uwsunlab/Kamome/Kamome_Pics/Kamome_Electronics.JPG

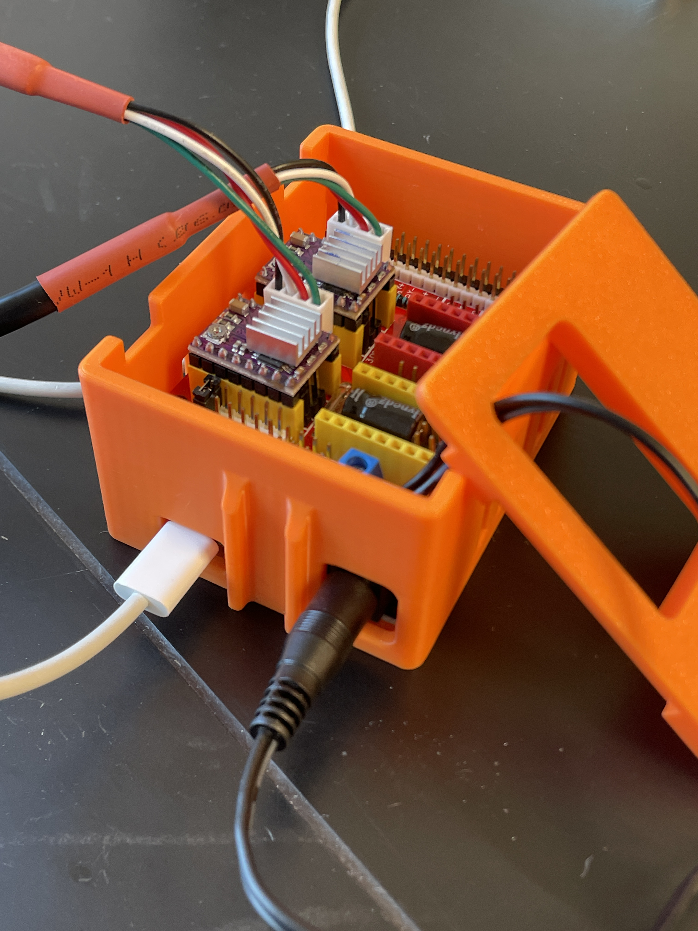
Kamome_Pics/Kamome_Electronics.JPG
