uwsunlab/Kamome/Kamome_Pics/Kamome_OT2_Setup.png

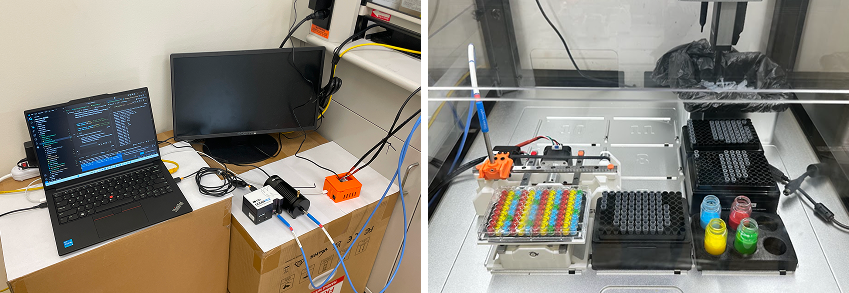
Kamome_Pics/Kamome_OT2_Setup.png
