uwsunlab/Kamome/README.md

# Welcome to Kamome's user and build guide!

## How to Use

## How to Build
