uwsunlab/Kamome/Kamome_Pics/Kamome_OT2_Pipetting.JPG

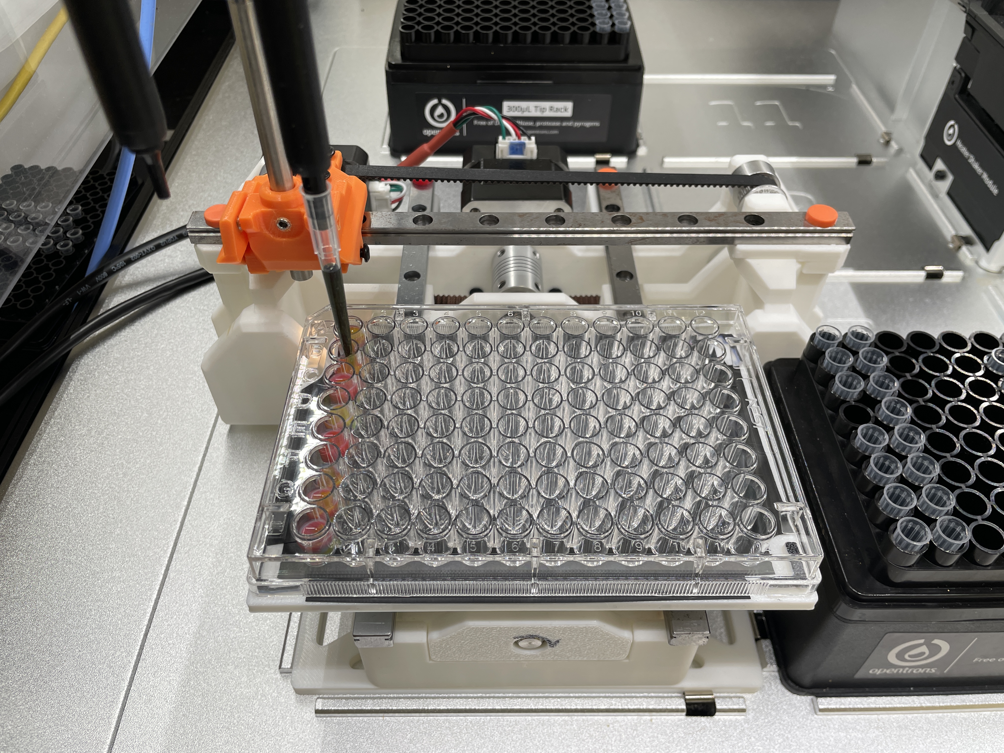
Kamome_Pics/Kamome_OT2_Pipetting.JPG
