uwsunlab/Kamome/Kamome_Pics/Kamome_OT2_Scanning.png

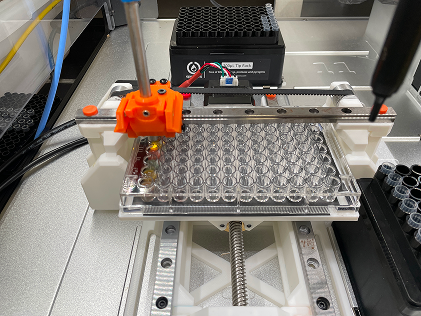
Kamome_Pics/Kamome_OT2_Scanning.png
