uwsunlab/Kamome/Kamome_Pics/Kamome_OT2_stationary.png

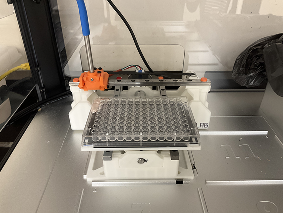
Kamome_Pics/Kamome_OT2_stationary.png
