uwsunlab/Kamome/Kamome_Pics/render_back.png

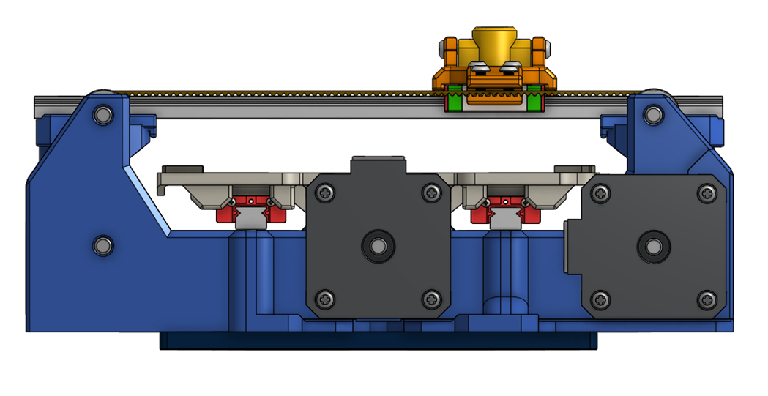
Kamome_Pics/render_back.png
