uwsunlab/Kamome/Kamome_Pics/render_front.png

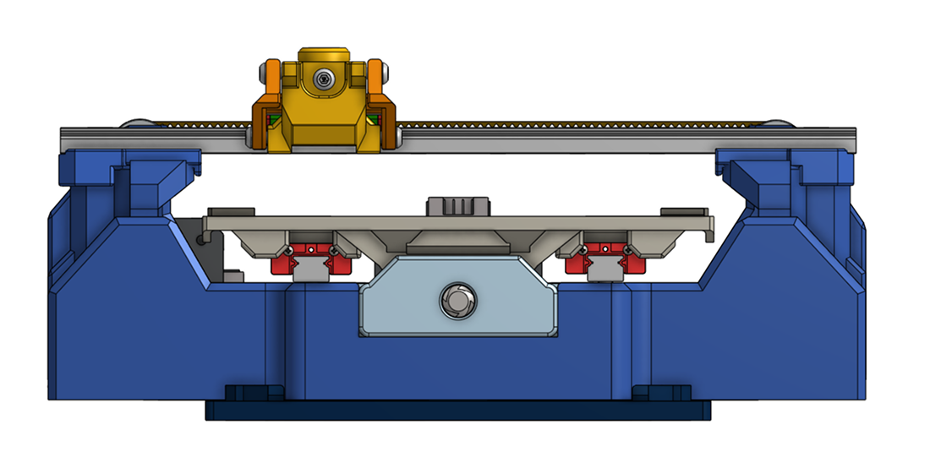
Kamome_Pics/render_front.png
