uwsunlab/Kamome/Kamome_Pics/render_frontright.png

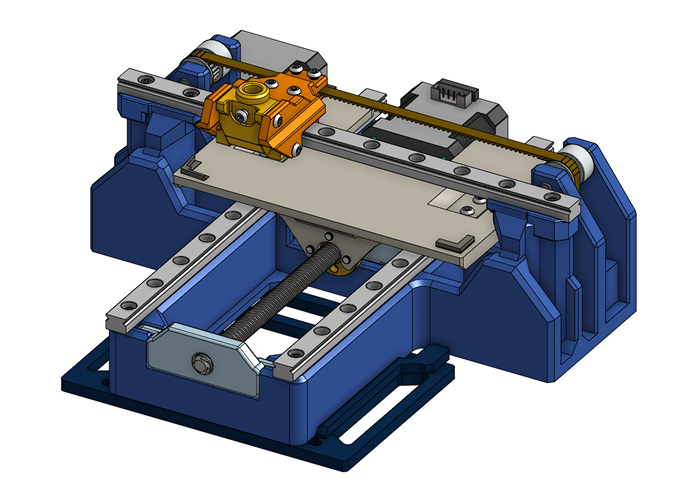
Kamome_Pics/render_frontright.png
