uwsunlab/Kamome/Kamome_Pics/render_frontright_all.png

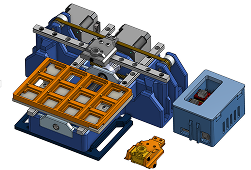
Kamome_Pics/render_frontright_all.png
