uwsunlab/Kamome/Kamome_Pics/render_top.png

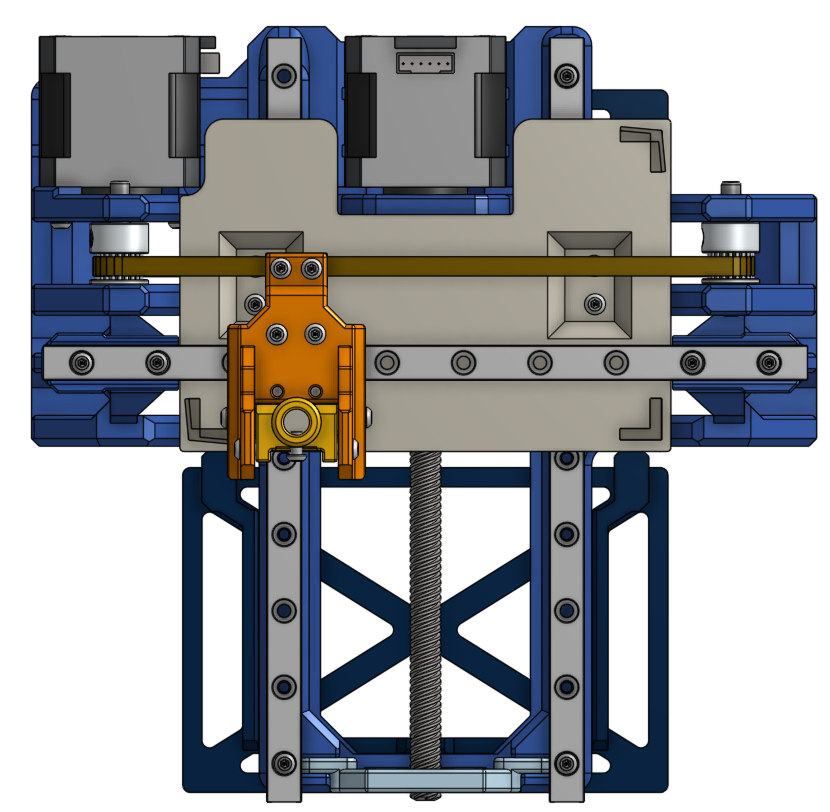
Kamome_Pics/render_top.png
