uwsunlab/Kamome/3D Print STEP files/Main Structure/Main Structure.step

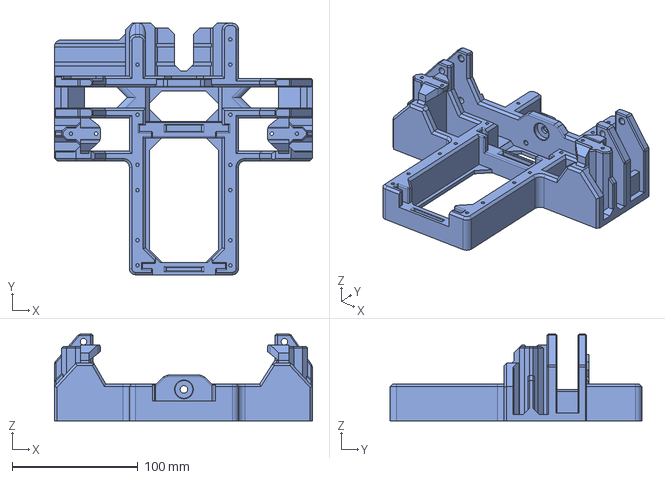
[picture p11: CAD file, 2025-05-07]
3D Print STEP files/Main Structure/Main Structure.step
205.5 x 200.4 x 69.0 mm
