uwsunlab/Kamome/3D Print STEP files/Custom Lab Plate Options/Thinfilm Plate.step

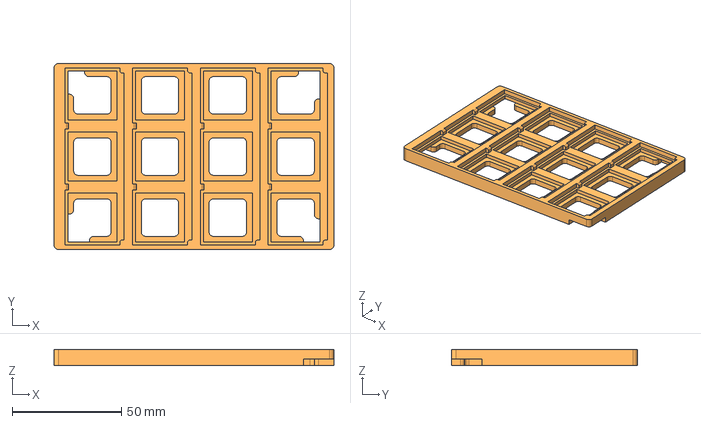
[picture p12: CAD file, 2025-05-07]
3D Print STEP files/Custom Lab Plate Options/Thinfilm Plate.step
128.0 x 85.0 x 7.50 mm
