uwsunlab/Kamome/3D Print STEP files/Electronics Box/Arduino Electronics Box.step

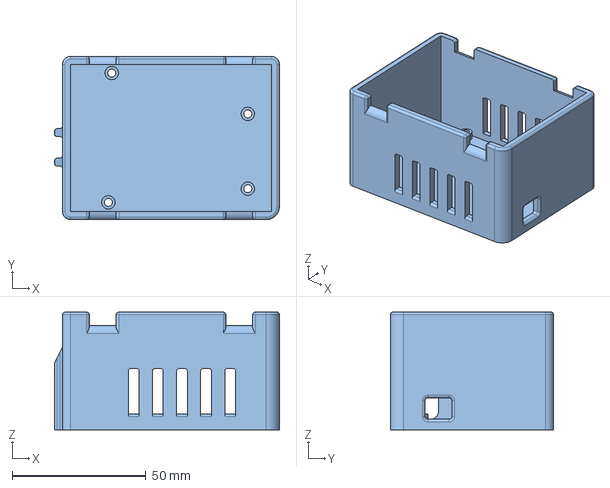
[picture p13: CAD file, 2025-05-07]
3D Print STEP files/Electronics Box/Arduino Electronics Box.step
84.0 x 61.0 x 44.0 mm
