uwsunlab/Kamome/3D Print STEP files/Probe Carriage Options/Vertical Probe Holder.step

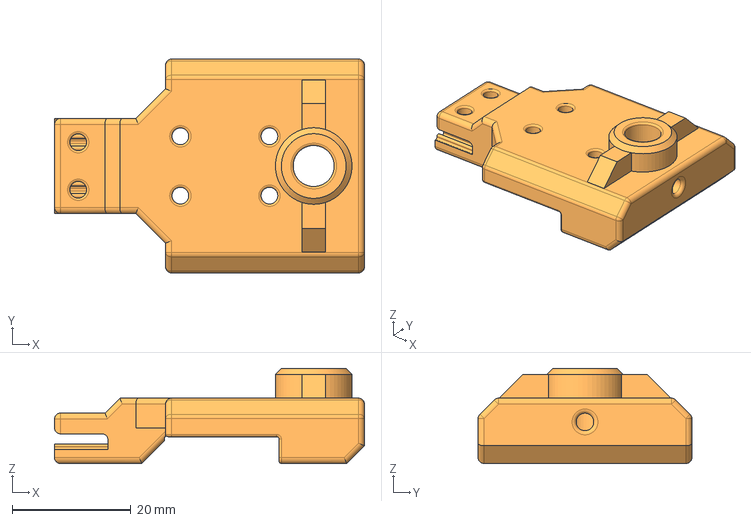
[picture p14: CAD file, 2025-05-07]
3D Print STEP files/Probe Carriage Options/Vertical Probe Holder.step
52.2 x 36.0 x 16.0 mm
