uwsunlab/Kamome/3D Print STEP files/Electronics Box/Arduino Electronics Box Roof.step

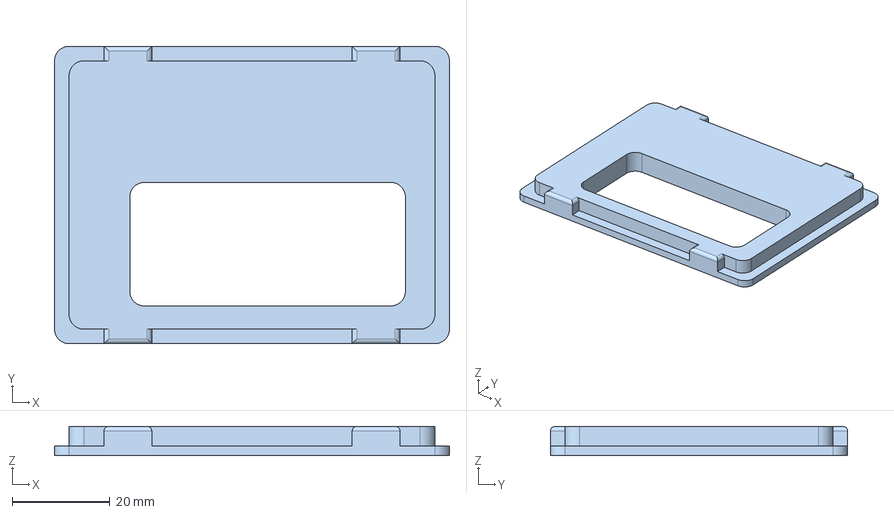
[picture p15: CAD file, 2025-05-07]
3D Print STEP files/Electronics Box/Arduino Electronics Box Roof.step
81.0 x 61.0 x 6.00 mm
