uwsunlab/Kamome/3D Print STEP files/Main Structure/Base Attachment Front Clip.step

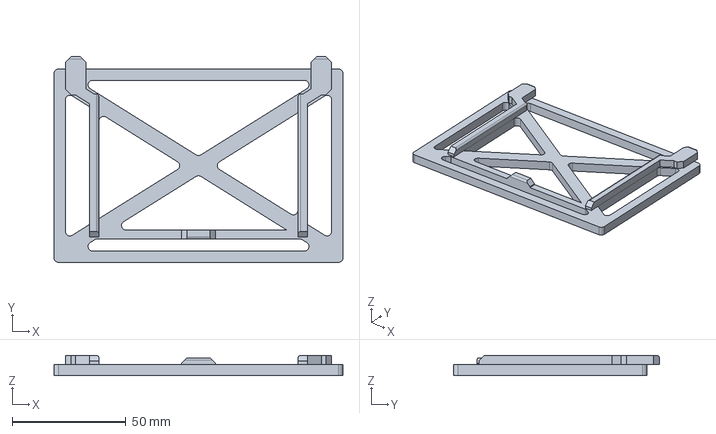
[picture p16: CAD file, 2025-05-07]
3D Print STEP files/Main Structure/Base Attachment Front Clip.step
127.0 x 90.4 x 8.80 mm
