uwsunlab/Kamome/3D Print STEP files/Probe Carriage Options/Angled Probe Holder Part 2.step

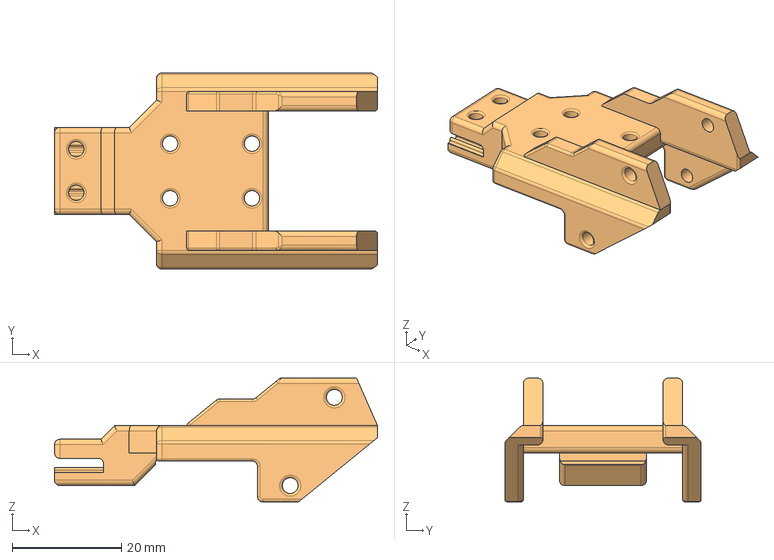
[picture p17: CAD file, 2025-05-07]
3D Print STEP files/Probe Carriage Options/Angled Probe Holder Part 2.step
59.2 x 36.0 x 22.7 mm
