uwsunlab/Kamome/3D Print STEP files/Main Structure/Base Attachment Universal.step

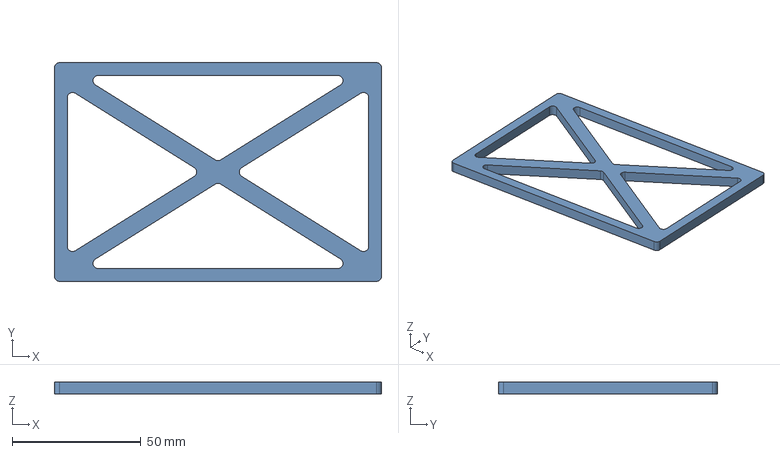
[picture p18: CAD file, 2025-05-07]
3D Print STEP files/Main Structure/Base Attachment Universal.step
127.0 x 85.0 x 4.80 mm
