uwsunlab/Kamome/3D Print STEP files/Probe Carriage Options/Angled Probe Holder Part 1.step

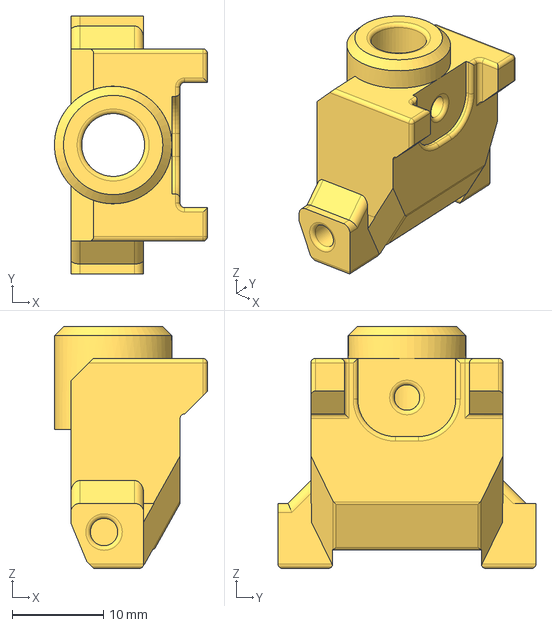
[picture p19: CAD file, 2025-05-07]
3D Print STEP files/Probe Carriage Options/Angled Probe Holder Part 1.step
16.8 x 28.3 x 26.6 mm
