uwsunlab/Kamome/3D Print STEP files/Main Structure/Plate Carriage.step

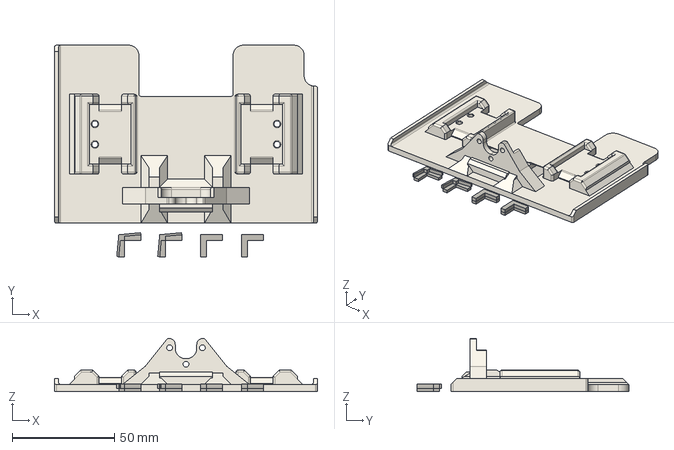
[picture p20: CAD file, 2025-05-07]
3D Print STEP files/Main Structure/Plate Carriage.step
128.5 x 103.4 x 26.0 mm
