uwsunlab/Kamome/3D Print STEP files/Main Structure/Guide Rail Support Right.step

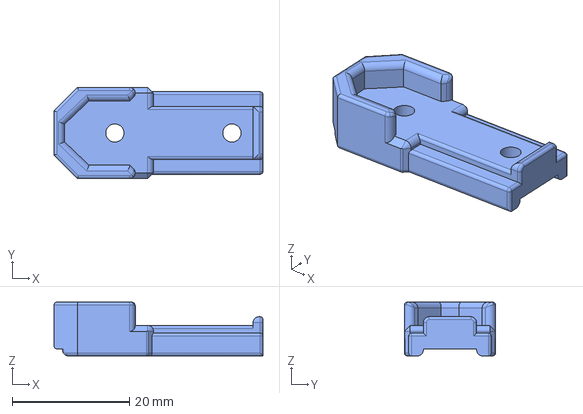
[picture p21: CAD file, 2025-05-07]
3D Print STEP files/Main Structure/Guide Rail Support Right.step
35.7 x 15.6 x 9.20 mm
