uwsunlab/Kamome/3D Print STEP files/Main Structure/Guide Rail Support Left.step

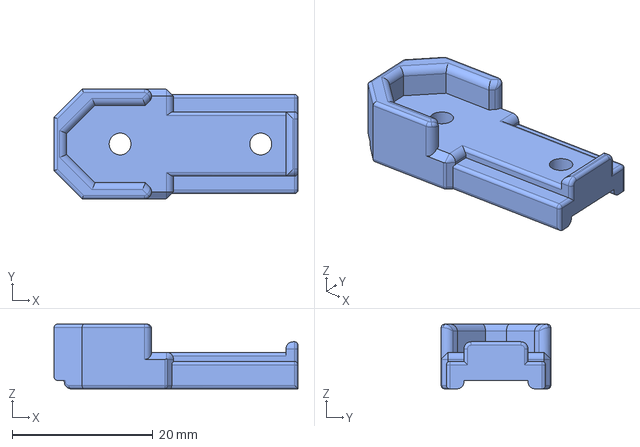
[picture p22: CAD file, 2025-05-07]
3D Print STEP files/Main Structure/Guide Rail Support Left.step
34.7 x 15.6 x 9.20 mm
