uwsunlab/Kamome/3D Print STEP files/Main Structure/Base Attachment Back Clip.step

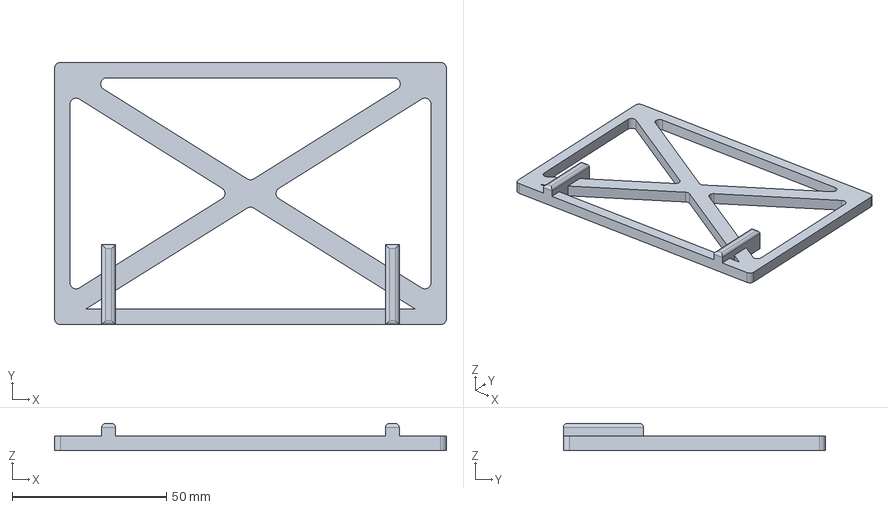
[picture p23: CAD file, 2025-05-07]
3D Print STEP files/Main Structure/Base Attachment Back Clip.step
127.0 x 85.0 x 8.80 mm
