uwsunlab/Kamome/3D Print STEP files/Main Structure/Lead Screw Modules.step

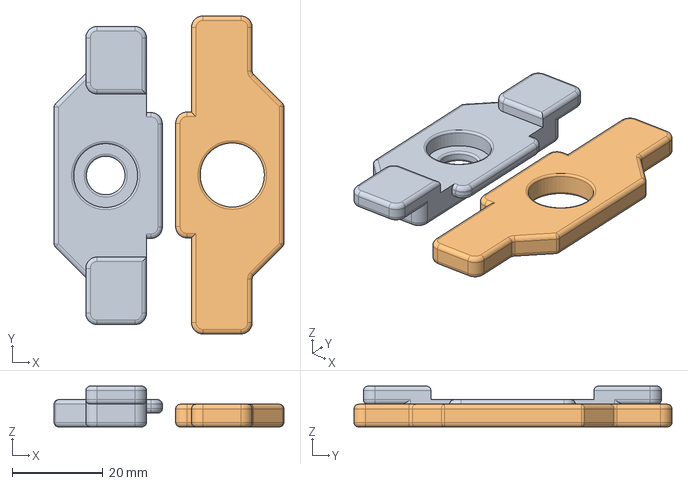
[picture p24: CAD file, 2025-05-07]
3D Print STEP files/Main Structure/Lead Screw Modules.step
50.7 x 70.2 x 9.00 mm
