uwsunlab/Kamome/Instructions/Assembly Instructions - Main.pdf

# Kamome Assembly

Instructions | 1

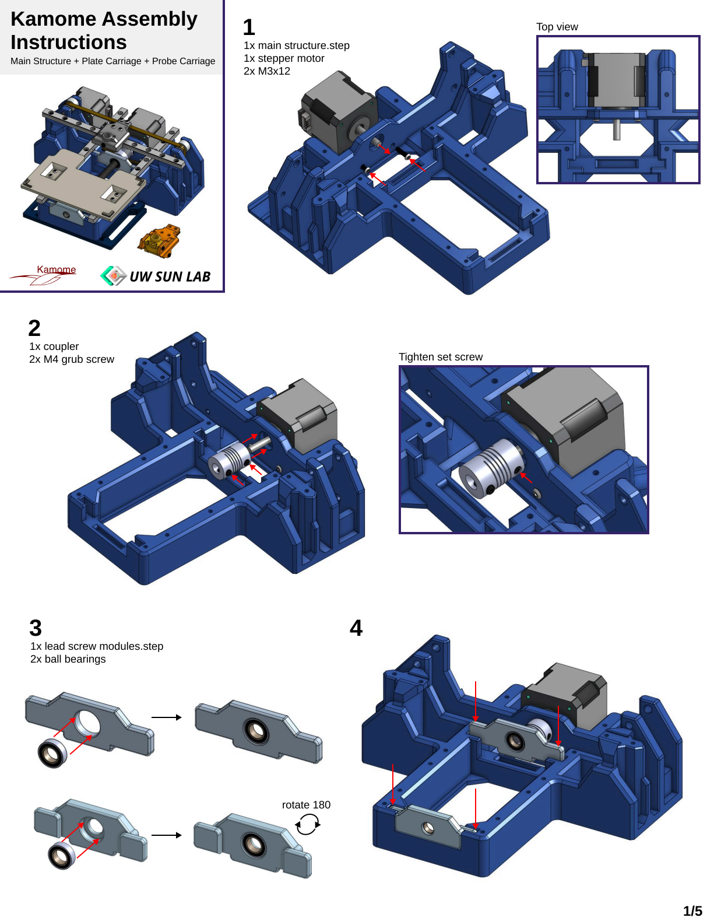
[picture p25: page 1]
1x stepper motor; 1x coupler; 2x M4 grub screw; 2x ball bearings; rotate 180; Top view

1x main structure.step

Main Structure + Plate Carriage + Probe Carriage

UW SUN LAB

Tighten set screw

1x lead screw modules.step

### 1x stepper motor 1x timing pulley

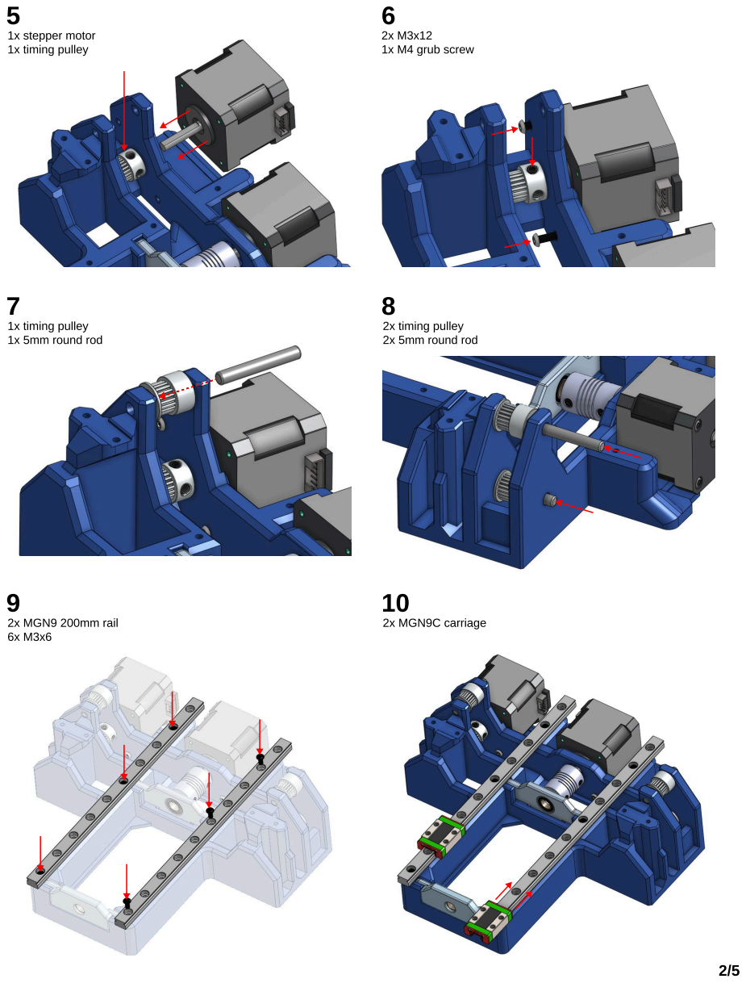
[picture p26: page 2]
1x timing pulley; 1x 5mm round rod; 2x timing pulley; 2x 5mm round rod; 2x MGN9 200mm rail; 2x MGN9C carriage; 1x M4 grub screw

# 1x plate carriage.step 1x lead screw nut

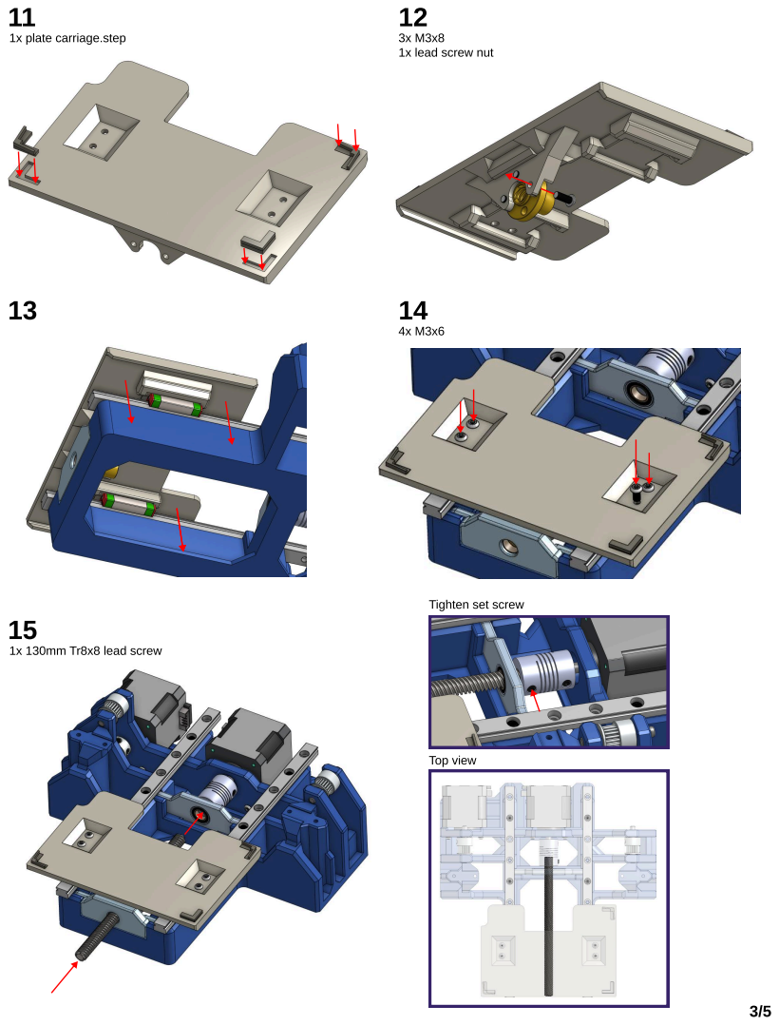
[picture p27: page 3]
1x 130mm Tr8x8 lead screw; Top view

Tighten set screw

16

## Check plate travel

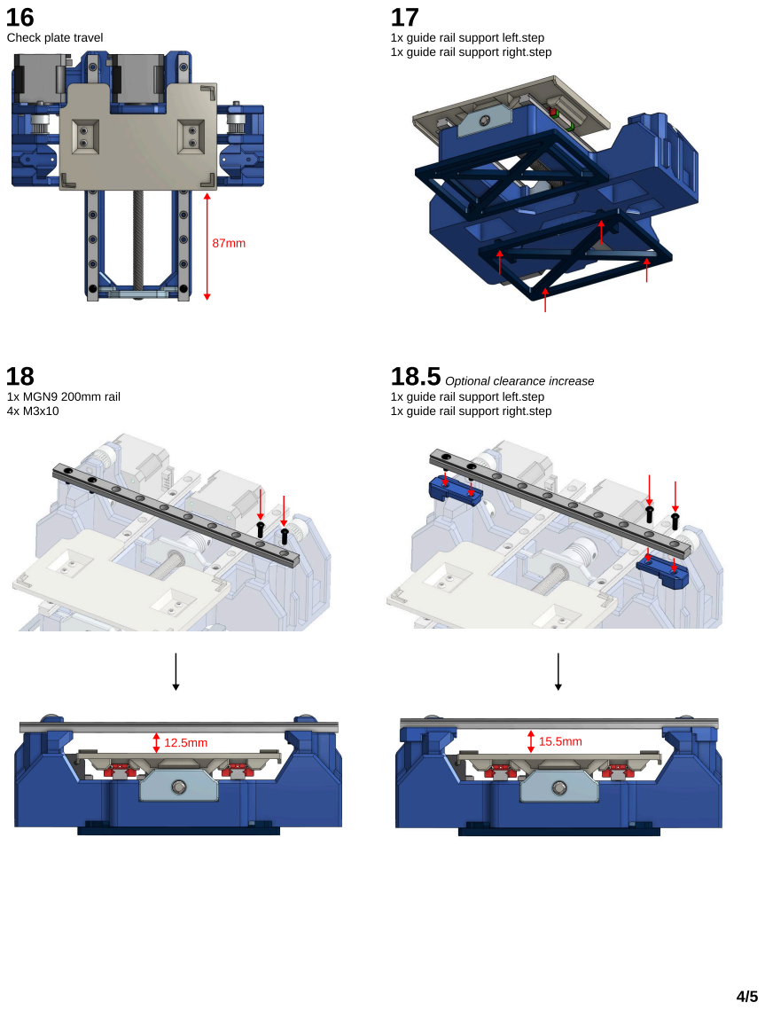
[picture p28: page 4]
1x MGN9 200mm rail 4x M3x10

1x guide rail support left.step
1x guide rail support right.step

Optional clearance increase

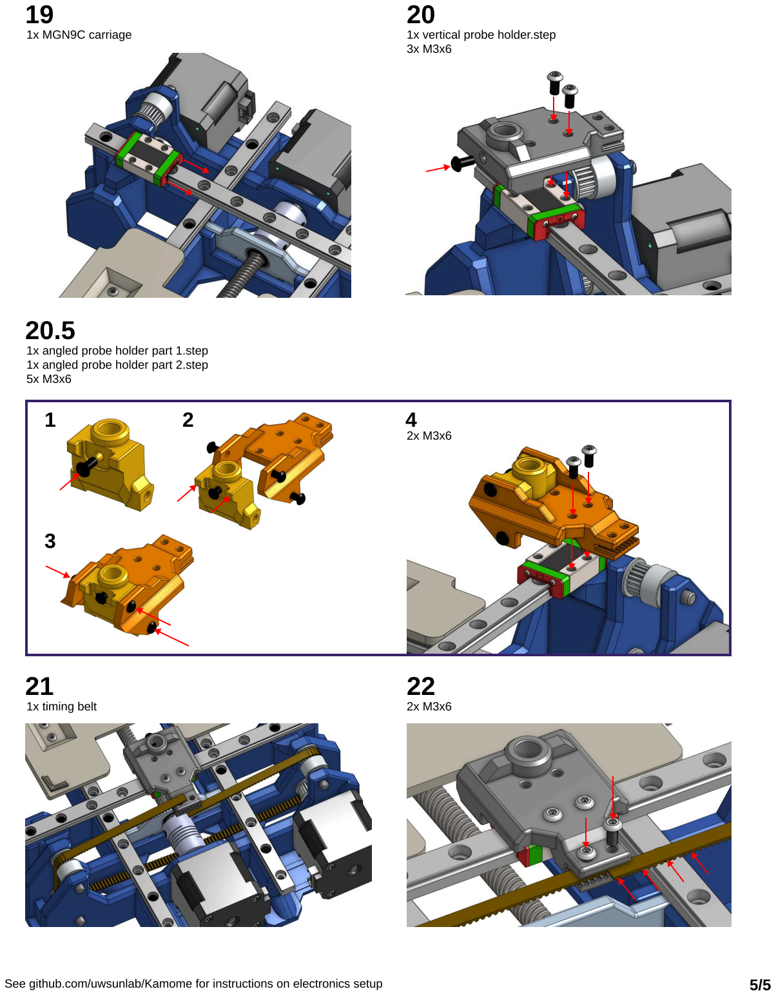
[picture p29: page 5]
1x MGN9C carriage; 1x vertical probe holder.step; 1x timing belt

1x angled probe holder part 1.step

1x angled probe holder part 2.step

See github.com/uwsunlab/Kamome for instructions on electronics setup
