uwsunlab/Kamome/Instructions/Assembly Instructions - Electronics Case.pdf

# Kamome Assembly

# Instructions

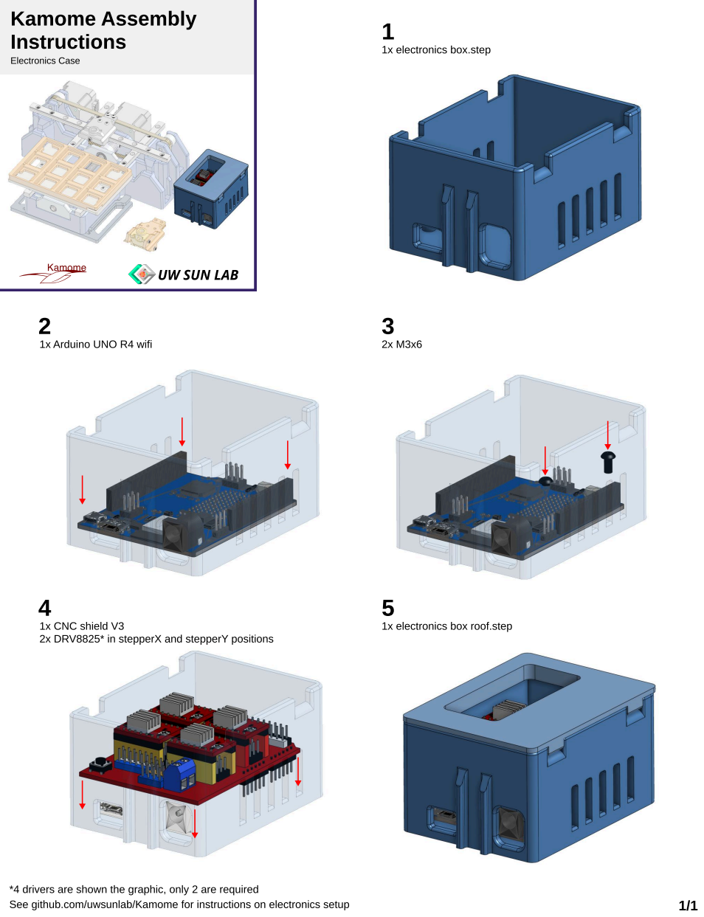
[picture p30: page 1]
Electronics Case; 1x Arduino UNO R4 wifi

1x electronics box.step

UW SUN LAB

1x CNC shield V3
2x DRV8825* in stepperX and stepperY positions

1x electronics box roof.step

*4 drivers are shown the graphic, only 2 are required
See github.com/uwsunlab/Kamome for instructions on electronics setup
